Phaiax/eggbot/Einkaufsliste_Backup1.ods

Einkaufsliste
arduino nano |  | 11 | bestellt |  | übersicht | https://www.arduino.cc/en/Main/ArduinoBoardNano
 |  |  |  |  | schaltplan | http://download.arduino.org/products/NANO/Arduino%20Nano-Rev3.2-SCH.pdf
 |  |  |  |  | atmega summary | http://www.atmel.com/Images/Atmel-42735-8-bit-AVR-Microcontroller-ATmega328-328P_Summary.pdf
Raspberry |  | 39 | bestellt | da | pinout | http://www.panu.it/raspberry/
 |  |  |  |  | goio benchmark | http://codeandlife.com/2012/07/03/benchmarking-raspberry-pi-gpio-speed/
 |  |  |  |  | features | http://elinux.org/RPi_Hardware
Wlan stick |  | 5 | bestellt | da
micro sd karte |  | 8 | bestellt | da
netzteil |  | 17.63 | bestellt | da da
2 stepper | 1.8 grad | 17.1 | bestellt | da |  | http://www.ebay.de/itm/262038536473
2 stepper driver |  | 11.55 | bestellt | da |  | http://www.ebay.de/itm/221727610250
baumarkt schrauben |  | 15
stifte |  | 15
holzverkleidung |  | 15
level shufter |  | 4.29 | bestellt |  |  | http://www.ebay.de/itm/222080420936
servo 10 stk |  | 18 | bestellt | da |  | http://www.ebay.de/itm/331886379174
tastenfeld |  | 7.26 | bestellt |  |  | 12 pins + 1 Gnd
oled |  | 9 | bestellt | da |  | http://www.ebay.de/itm/222193031364
 |  | 181.82999999999996
 |  | 200
