Phaiax/eggbot/stls/arm1.stl

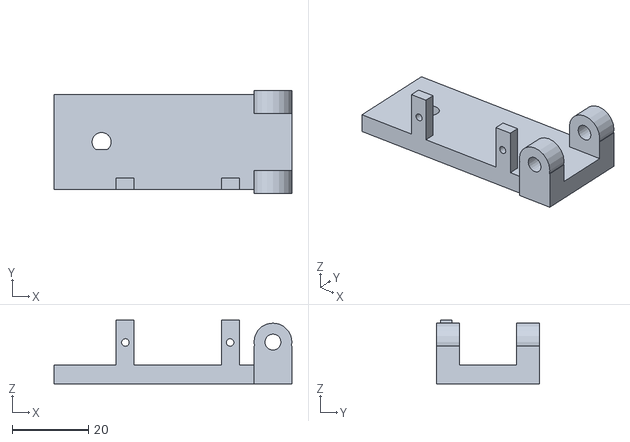
[picture p1: CAD file, 2016-12-21]
stls/arm1.stl
62.5 x 27.0 x 16.8
