Phaiax/eggbot/vertical_ARM_v2.stl

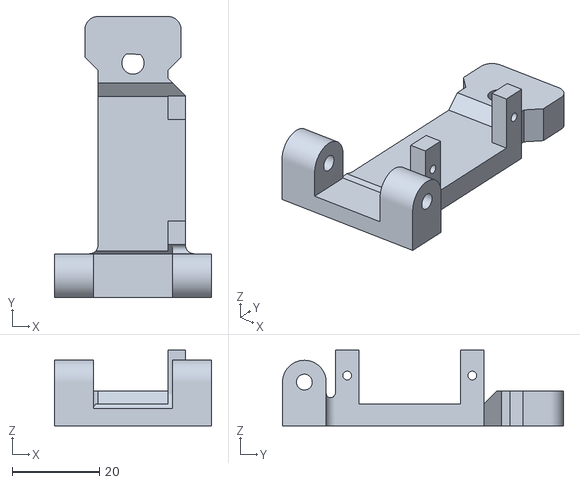
[picture p2: CAD file, 2016-12-21]
vertical_ARM_v2.stl
36.0 x 64.3 x 17.3
