Phaiax/eggbot/pen_holder_v3.stl

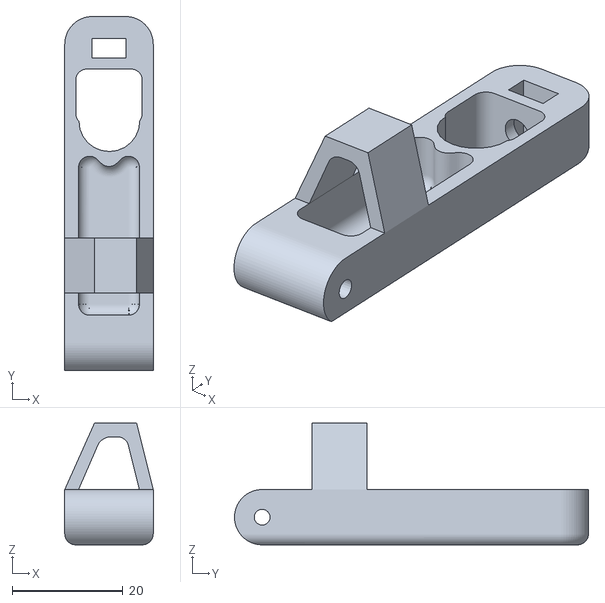
[picture p3: CAD file, 2016-12-21]
pen_holder_v3.stl
16.0 x 64.0 x 22.0
