Phaiax/eggbot/stls/elevator.stl

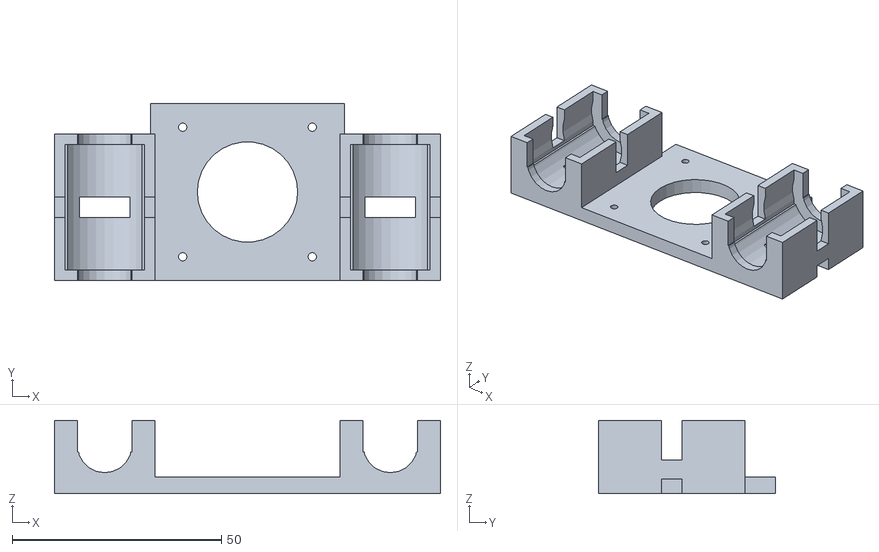
[picture p4: CAD file, 2016-12-21]
stls/elevator.stl
92.3 x 42.3 x 17.5
