Phaiax/eggbot/pi_bottom.stl

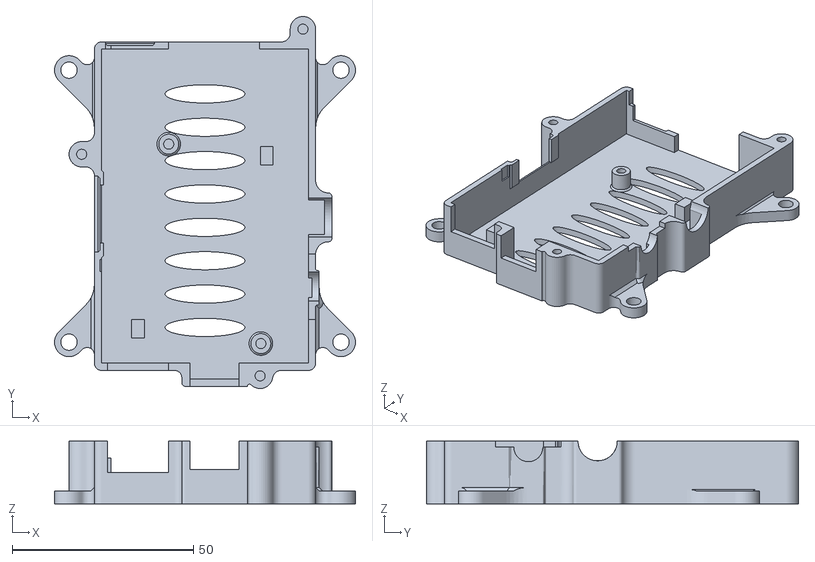
[picture p5: CAD file, 2016-12-04]
pi_bottom.stl
83.0 x 102.6 x 17.3
