Phaiax/eggbot/stls/eggholder_top.stl

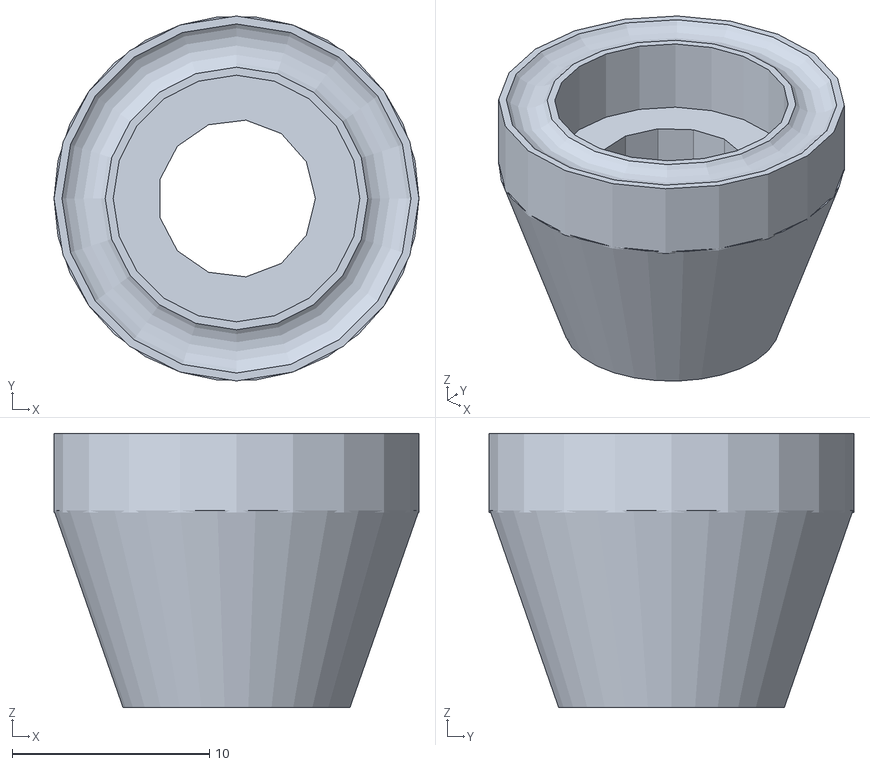
[picture p6: CAD file, 2016-12-21]
stls/eggholder_top.stl
18.5 x 18.5 x 13.9
