Phaiax/eggbot/pi_top.stl

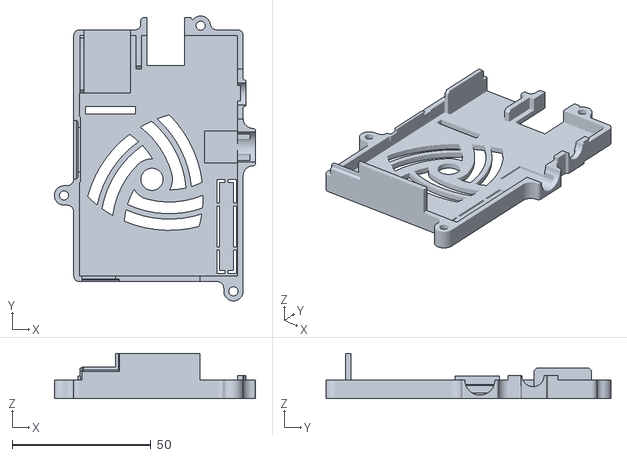
[picture p7: CAD file, 2016-12-04]
pi_top.stl
72.5 x 102.6 x 16.4
