Phaiax/eggbot/stls/arm2.stl

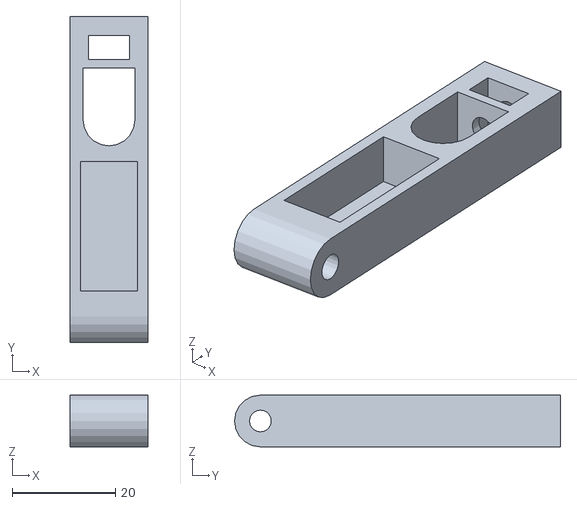
[picture p8: CAD file, 2016-12-21]
stls/arm2.stl
15.0 x 63.0 x 10.0
