Phaiax/eggbot/stls/arm1_extra.stl

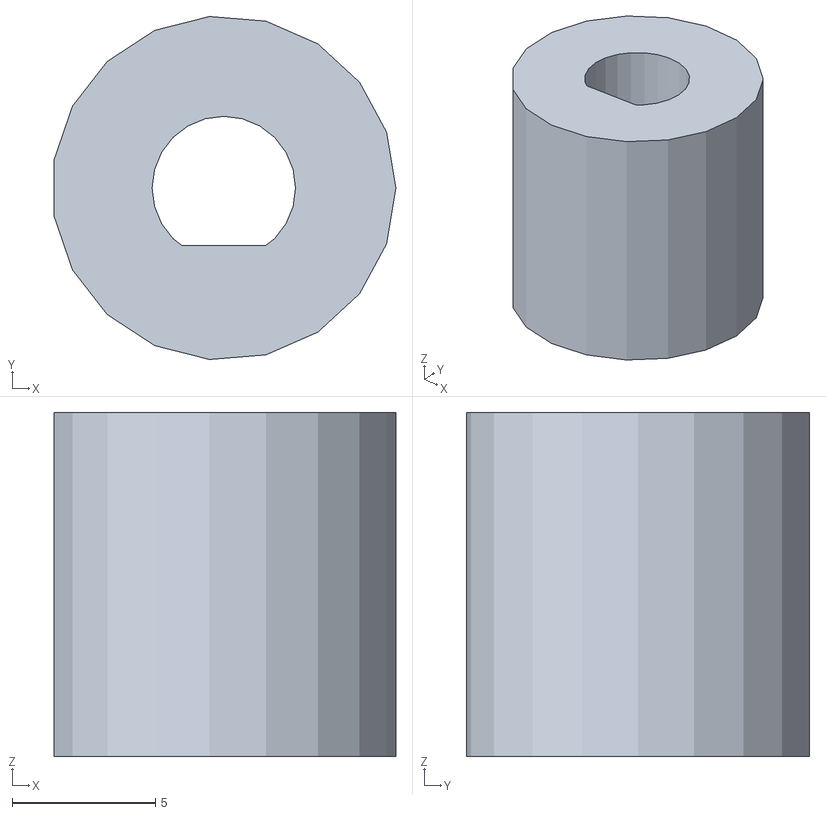
[picture p9: CAD file, 2016-12-21]
stls/arm1_extra.stl
11.9 x 12.0 x 12.0
