Phaiax/eggbot/stls/clamp.stl

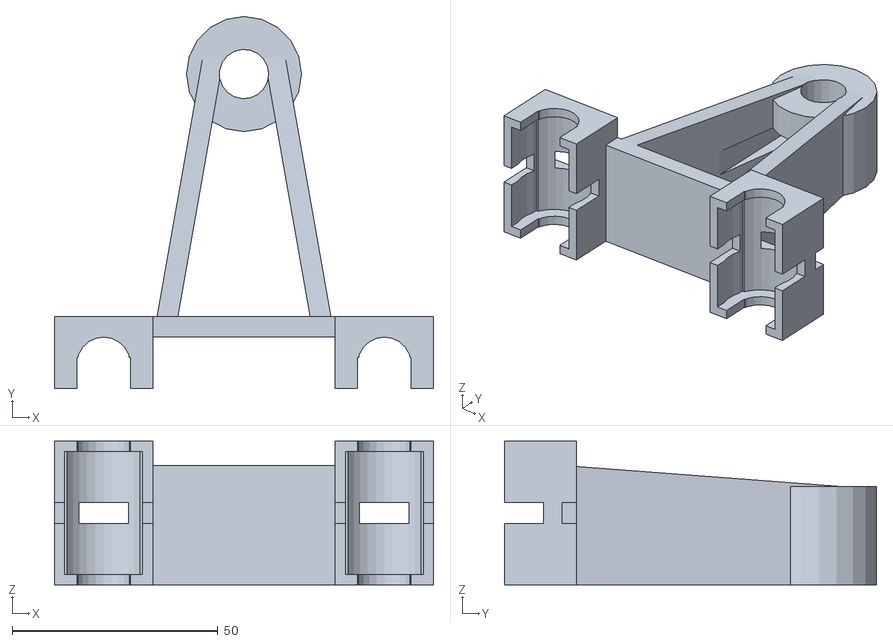
[picture p10: CAD file, 2016-12-21]
stls/clamp.stl
92.3 x 90.5 x 35.0
