Phaiax/eggbot/stls/eggholder_bot.stl

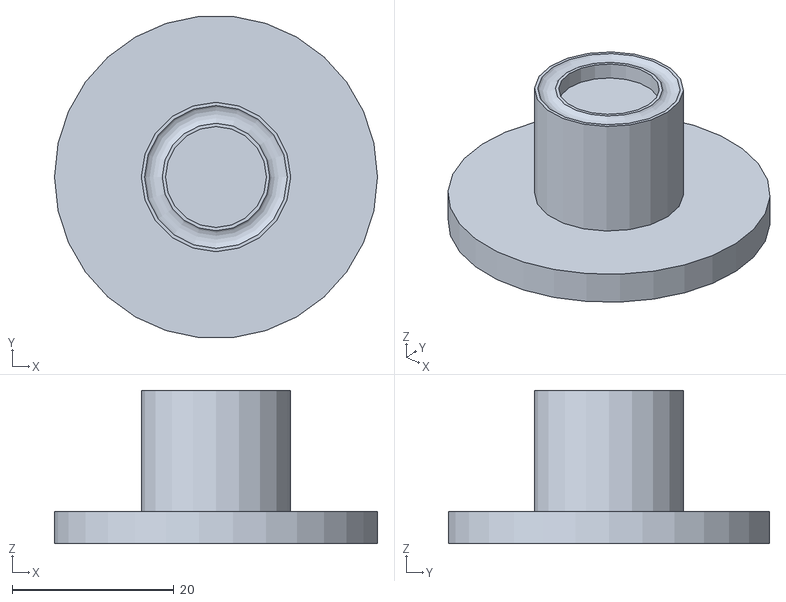
[picture p11: CAD file, 2016-12-21]
stls/eggholder_bot.stl
40.0 x 39.8 x 19.0
