Phaiax/eggbot/(list of files, cad)

Other CAD files:
unused.scad
