Phaiax/eggbot/schematics/eggbothat3.brd

## EAGLE design schematics/eggbothat3.brd (2016-12-13)

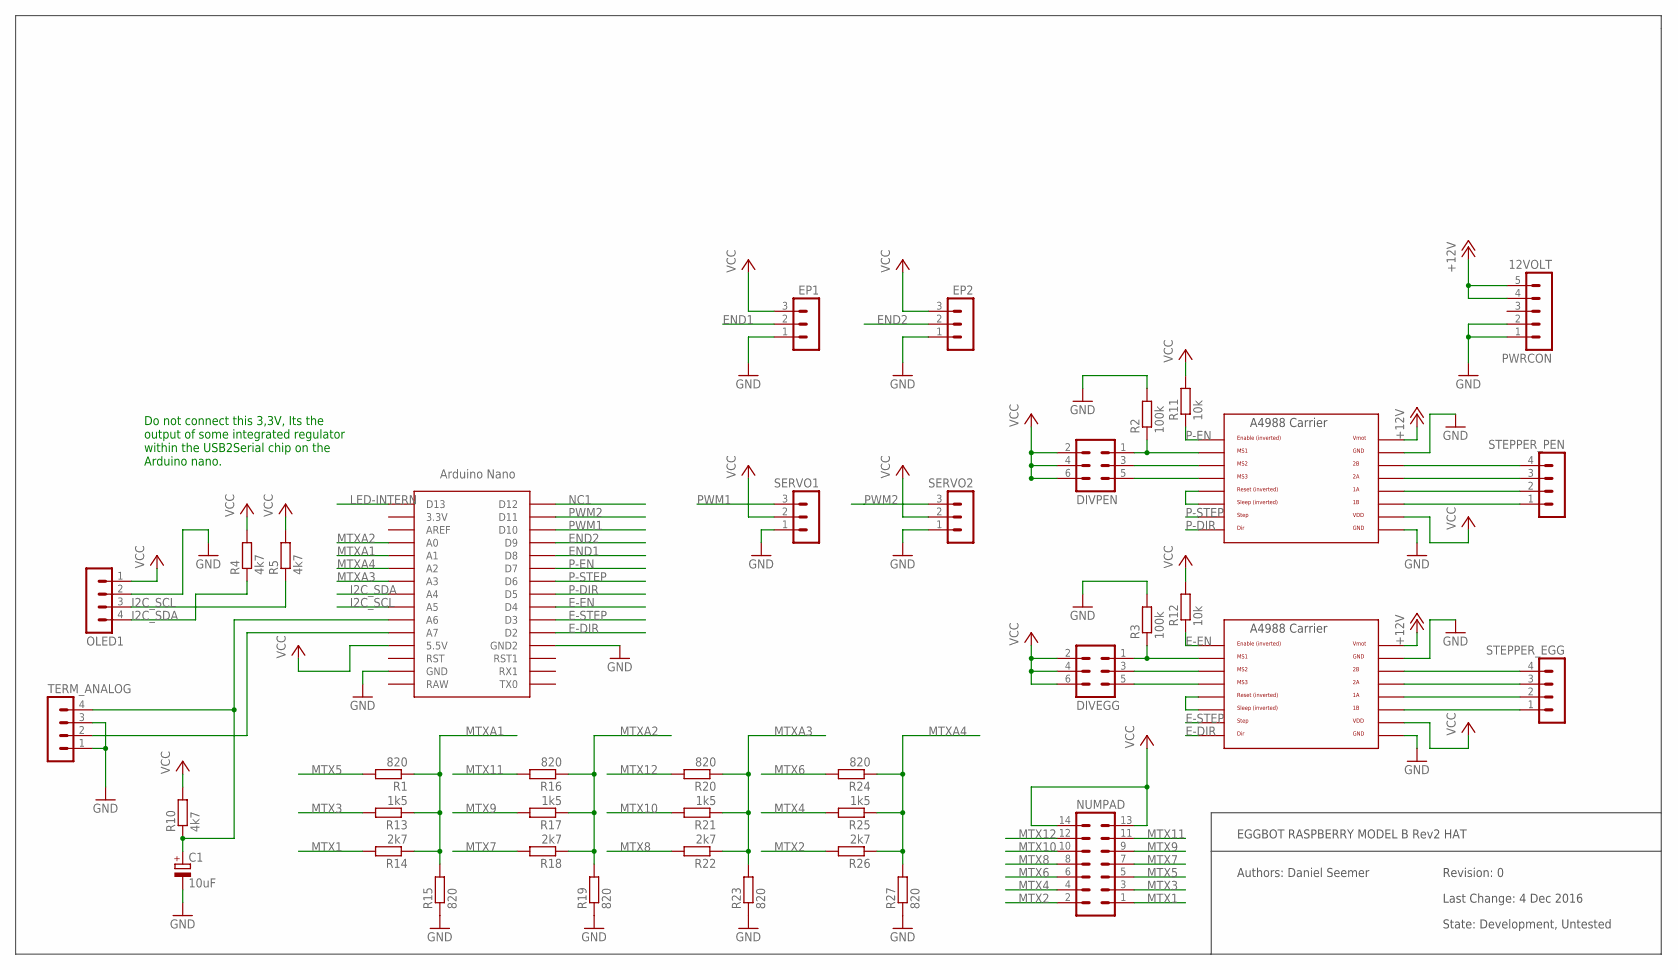
[picture p12: schematic eggbothat3.sch, sheet 1]

Parts:
12VOLT: PWRCON; MA05-1
C1: 10uF; E2,5-5
DIVEGG: MA03-2
DIVPEN: MA03-2
EP1, EP2: MA03-1
NUMPAD: MA07-2
OLED1: MA04-1
R1, R15, R16, R19, R20, R23, R24, R27: 820; R1206
R2, R3: 100k; R1206
R4, R5, R10: 4k7; R1206
R11, R12: 10k; R1206
R13, R17, R21, R25: 1k5; R1206
R14, R18, R22, R26: 2k7; R1206
SERVO1, SERVO2: MA03-1
STEPPER_EGG: MA04-1
STEPPER_PEN: MA04-1
TERM_ANALOG: MA04-1
U$1, U$2: A4988BREAKOUT
U$4: NANO

Connections:
+12V: 12VOLT.4, 12VOLT.5, U$1.VMOT, U$2.VMOT
E-DIR: U$2.DIR, U$4.D2
E-EN: R12.1, U$2.EN, U$4.D4
E-STEP: U$2.STEP, U$4.D3
END1: EP1.2, U$4.D8
END2: EP2.2, U$4.D9
GND: 12VOLT.1, 12VOLT.2, C1.-, EP1.1, EP2.1, OLED1.2, R2.2, R3.2, R15.1, R19.1, R23.1, R27.1, SERVO1.1, SERVO2.1, TERM_ANALOG.1, TERM_ANALOG.3, U$1.GND, U$1.GND@0 (GND), U$2.GND, U$2.GND@0 (GND), U$4.GND, U$4.GND1 (GND2)
I2C_SCL: OLED1.3, R5.1, U$4.A5
I2C_SDA: OLED1.4, R4.1, U$4.A4
LED-INTERN: U$4.D13
MTX1: NUMPAD.1, R14.2
MTX2: NUMPAD.2, R26.2
MTX3: NUMPAD.3, R13.2
MTX4: NUMPAD.4, R25.2
MTX5: NUMPAD.5, R1.2
MTX6: NUMPAD.6, R24.2
MTX7: NUMPAD.7, R18.2
MTX8: NUMPAD.8, R22.2
MTX9: NUMPAD.9, R17.2
MTX10: NUMPAD.10, R21.2
MTX11: NUMPAD.11, R16.2
MTX12: NUMPAD.12, R20.2
MTXA1: R1.1, R13.1, R14.1, R15.2, U$4.A1
MTXA2: R16.1, R17.1, R18.1, R19.2, U$4.A0
MTXA3: R20.1, R21.1, R22.1, R23.2, U$4.A3
MTXA4: R24.1, R25.1, R26.1, R27.2, U$4.A2
unnamed: STEPPER_PEN.4, U$1.2B
unnamed: STEPPER_PEN.3, U$1.2A
unnamed: STEPPER_PEN.2, U$1.1A
unnamed: STEPPER_PEN.1, U$1.1B
unnamed: STEPPER_EGG.4, U$2.2B
unnamed: STEPPER_EGG.3, U$2.2A
unnamed: STEPPER_EGG.2, U$2.1A
unnamed: STEPPER_EGG.1, U$2.1B
unnamed: DIVPEN.3, U$1.MS2
unnamed: DIVPEN.1, R2.1, U$1.MS1
unnamed: DIVPEN.5, U$1.MS3
unnamed: DIVEGG.3, U$2.MS2
unnamed: DIVEGG.1, R3.1, U$2.MS1
unnamed: DIVEGG.5, U$2.MS3
unnamed: U$1.RST, U$1.SLP (SLEEP)
unnamed: U$2.RST, U$2.SLP (SLEEP)
unnamed: C1.+, R10.1, TERM_ANALOG.4, U$4.A6
unnamed: TERM_ANALOG.2, U$4.A7
NC1: U$4.D12
P-DIR: U$1.DIR, U$4.D5
P-EN: R11.1, U$1.EN, U$4.D7
P-STEP: U$1.STEP, U$4.D6
PWM1: SERVO1.3, U$4.D10
PWM2: SERVO2.3, U$4.D11
VCC: DIVEGG.2, DIVEGG.4, DIVEGG.6, DIVPEN.2, DIVPEN.4, DIVPEN.6, EP1.3, EP2.3, NUMPAD.13, NUMPAD.14, OLED1.1, R4.2, R5.2, R10.2, R11.2, R12.2, SERVO1.2, SERVO2.2, U$1.VDD, U$2.VDD, U$4.5V (5.5V)

Notes on the sheet:
Do not connect this 3,3V, Its the output of some integrated regulator within the USB2Serial chip on the Arduino nano.
EGGBOT RASPBERRY MODEL B Rev2 HAT
Authors: Daniel Seemer
Last Change: 4 Dec 2016
State: Development, Untested
Revision: 0

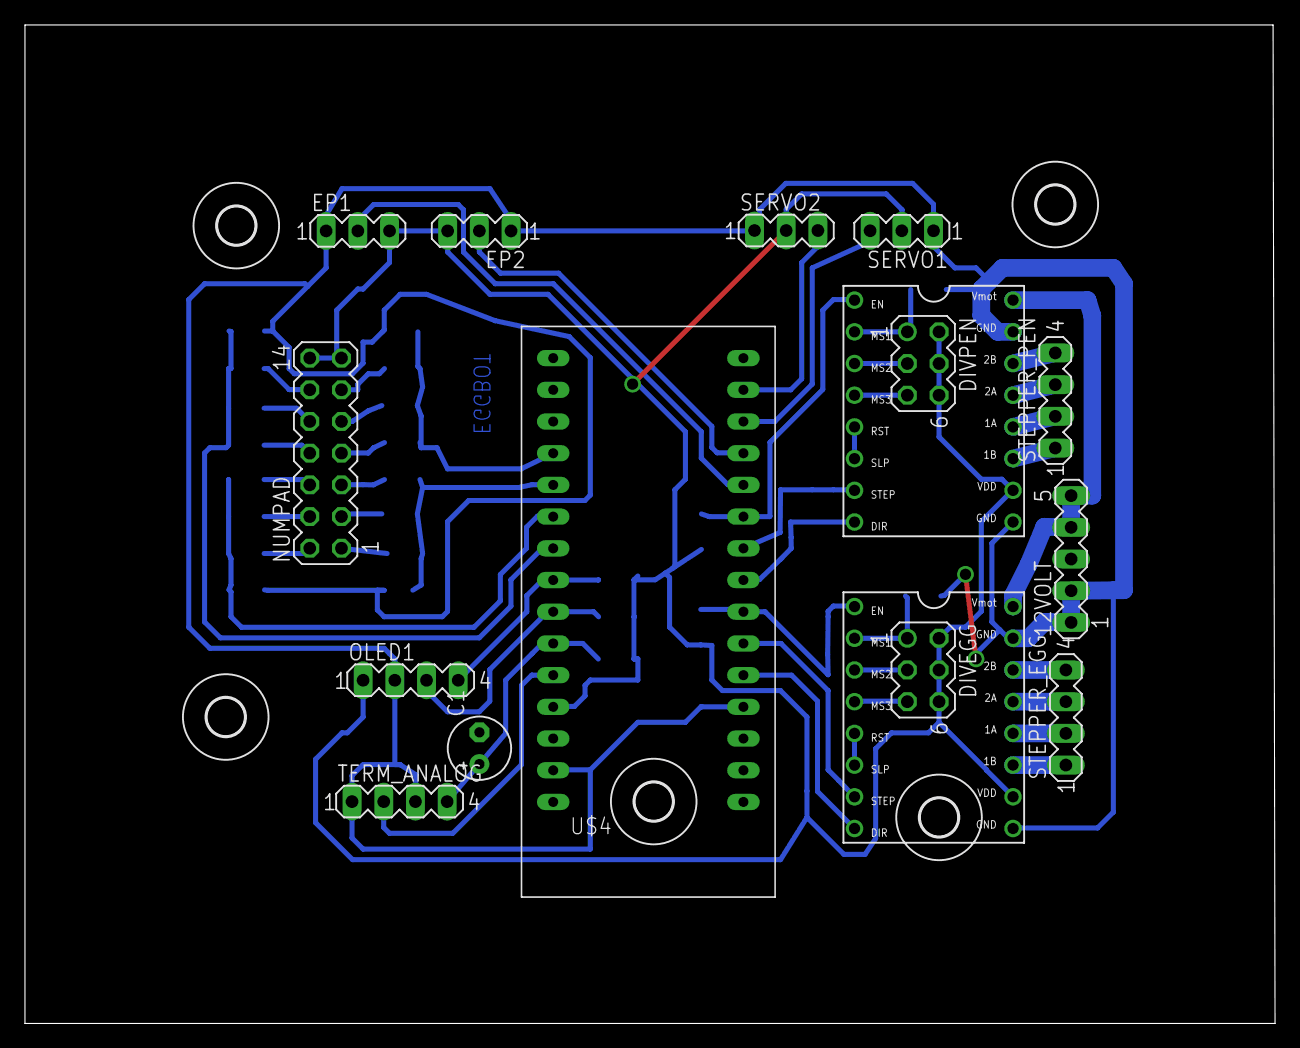
[picture p13: board eggbothat3.brd from above]

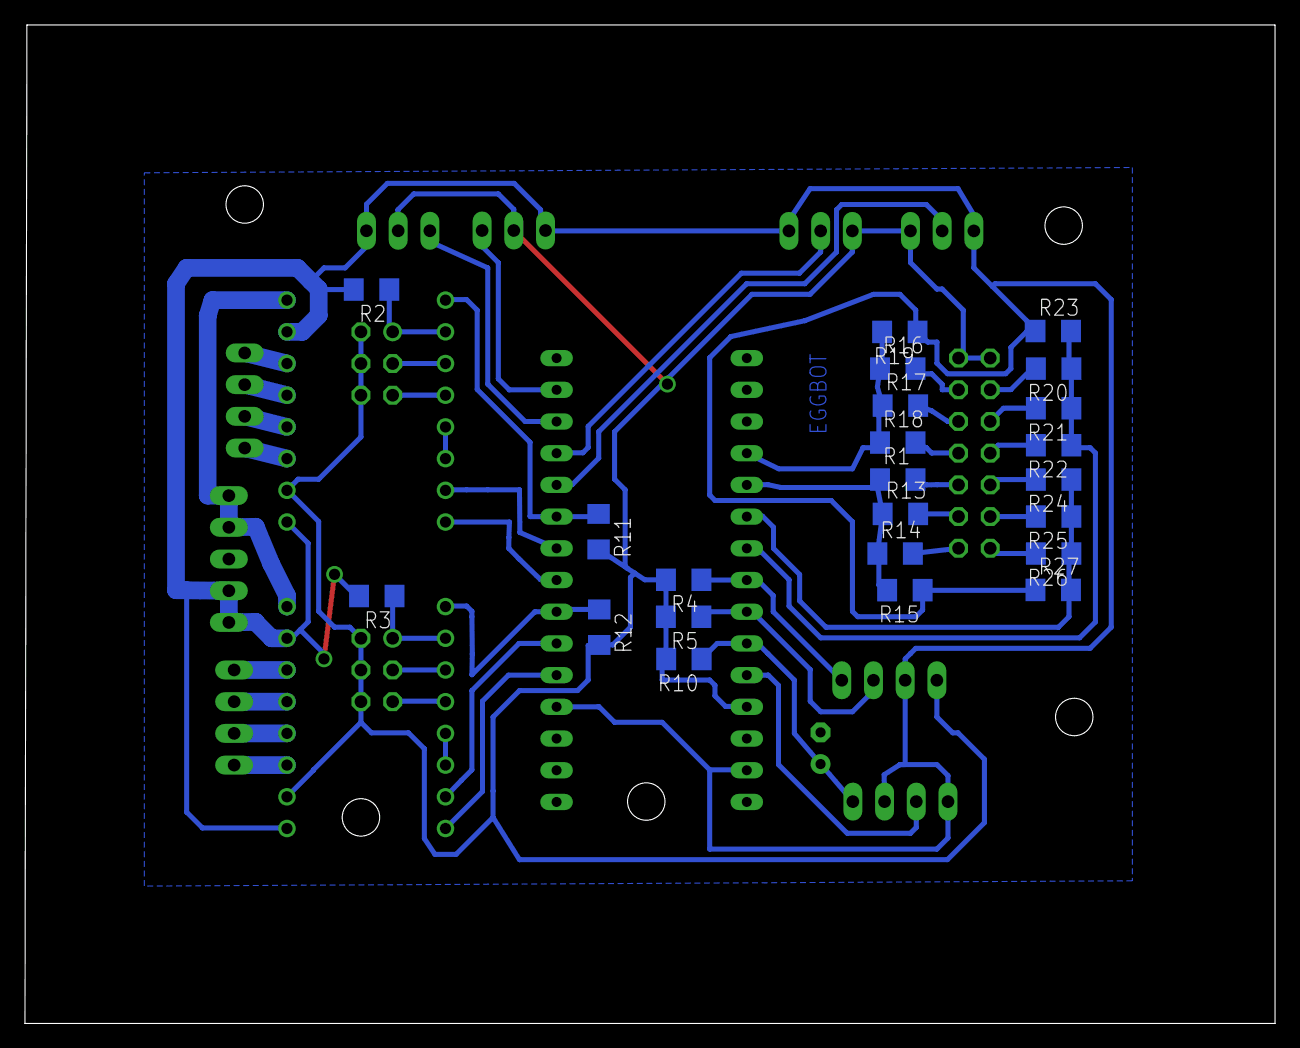
[picture p14: board eggbothat3.brd from below]

Board: 2 copper layers, 100.2 x 80.0 mm, 44 parts (23 on the bottom side), 49 nets.

Other parts of the board:
U$3, U$5, U$6, U$7, U$8: 3,0
