Phaiax/eggbot/arduinonanotest/src/Configuration.h

#define CONFIGURATION_H
#include "pins.h"
#define DRIVE_SYSTEM 0
#define XAXIS_STEPS_PER_MM 98.425196
#define YAXIS_STEPS_PER_MM 98.425196
#define ZAXIS_STEPS_PER_MM 2560
#define SUPPORT_LASER 0 // set 1 to enable laser support
#define LASER_PIN -1    // set to pin enabling laser
#define LASER_ON_HIGH 1 // Set 0 if low signal enables laser
#define SUPPORT_CNC 0 // Set 1 for CNC support
#define CNC_WAIT_ON_ENABLE 300 // wait x milliseconds after enabling
#define CNC_WAIT_ON_DISABLE 0 // delay in milliseconds after disabling spindle. May be required for direction changes.
#define CNC_ENABLE_PIN -1 // Pin to enable mill
#define CNC_ENABLE_WITH 1 // Set 0 if low enables spindle
#define CNC_DIRECTION_PIN -1 // Set to pin if direction control is possible
#define CNC_DIRECTION_CW 1 // Set signal required for clockwise rotation
#define DEFAULT_PRINTER_MODE PRINTER_MODE_FFF
#define ENDSTOP_PULLUP_X_MIN false
#define ENDSTOP_PULLUP_Y_MIN false
#define ENDSTOP_PULLUP_Z_MIN false
#define ENDSTOP_PULLUP_X_MAX true
#define ENDSTOP_PULLUP_Y_MAX true
#define ENDSTOP_PULLUP_Z_MAX false
#define ENDSTOP_X_MIN_INVERTING true
#define ENDSTOP_Y_MIN_INVERTING true
#define ENDSTOP_Z_MIN_INVERTING true
#define ENDSTOP_X_MAX_INVERTING false
#define ENDSTOP_Y_MAX_INVERTING false
#define ENDSTOP_Z_MAX_INVERTING true
#define MIN_HARDWARE_ENDSTOP_X true
#define MIN_HARDWARE_ENDSTOP_Y true
#define MIN_HARDWARE_ENDSTOP_Z false
#define MAX_HARDWARE_ENDSTOP_X false
#define MAX_HARDWARE_ENDSTOP_Y false
#define MAX_HARDWARE_ENDSTOP_Z true
#define X_ENABLE_ON 0
#define Y_ENABLE_ON 0
#define Z_ENABLE_ON 0
#define DISABLE_X false
#define DISABLE_Y false
#define DISABLE_Z false
#define DISABLE_E false
#define INVERT_X_DIR true
#define INVERT_Y_DIR true
#define INVERT_Z_DIR true
#define X_HOME_DIR -1
#define Y_HOME_DIR -1
#define Z_HOME_DIR 1
#define max_software_endstop_r true
#define min_software_endstop_x false
#define min_software_endstop_y false
#define min_software_endstop_z false
#define max_software_endstop_x true
#define max_software_endstop_y true
#define max_software_endstop_z false
#define ENDSTOP_X_BACK_MOVE 5
#define ENDSTOP_Y_BACK_MOVE 5
#define ENDSTOP_Z_BACK_MOVE 2
#define ENDSTOP_X_RETEST_REDUCTION_FACTOR 2
#define ENDSTOP_Y_RETEST_REDUCTION_FACTOR 2
#define ENDSTOP_Z_RETEST_REDUCTION_FACTOR 2
#define ENDSTOP_X_BACK_ON_HOME 1
#define ENDSTOP_Y_BACK_ON_HOME 1
#define ENDSTOP_Z_BACK_ON_HOME 0
#define ALWAYS_CHECK_ENDSTOPS 1
#define X_MAX_LENGTH 165
#define Y_MAX_LENGTH 175
#define Z_MAX_LENGTH 116.820
#define X_MIN_POS 0
#define Y_MIN_POS 0
#define Z_MIN_POS 0
#define MICROSTEP_MODES {8,8,8,8,8} // [1,2,4,8,16]
#if MOTHERBOARD==301
#define MOTOR_CURRENT_PERCENT {53,53,53,53,53}
#elif MOTHERBOARD==12
#define MOTOR_CURRENT_PERCENT {55,55,55,55,55}
#endif
#define STEPPER_INACTIVE_TIME 360
#define MAX_INACTIVE_TIME 0L
#define MAX_FEEDRATE_X 200
#define MAX_FEEDRATE_Y 200
#define MAX_FEEDRATE_Z 5
#define HOMING_FEEDRATE_X 80
#define HOMING_FEEDRATE_Y 80
#define HOMING_FEEDRATE_Z 3
#define HOMING_ORDER HOME_ORDER_ZXY
#define ZHOME_MIN_TEMPERATURE 0
#define ZHOME_HEAT_ALL 1
#define ZHOME_HEAT_HEIGHT 20
#define ZHOME_X_POS IGNORE_COORDINATE
#define ZHOME_Y_POS IGNORE_COORDINATE
#define ENABLE_BACKLASH_COMPENSATION 0
#define Z_BACKLASH 0
#define X_BACKLASH 0
#define Y_BACKLASH 0
#define RAMP_ACCELERATION 1
#define STEPPER_HIGH_DELAY 0
#define DIRECTION_DELAY 0
#define STEP_DOUBLER_FREQUENCY 12000
#define ALLOW_QUADSTEPPING 1
#define DOUBLE_STEP_DELAY 0 // time in microseconds
#define KEEP_ALIVE_INTERVAL 2000
#define MAX_ACCELERATION_UNITS_PER_SQ_SECOND_X 1000
#define MAX_ACCELERATION_UNITS_PER_SQ_SECOND_Y 1000
#define MAX_ACCELERATION_UNITS_PER_SQ_SECOND_Z 100
#define MAX_TRAVEL_ACCELERATION_UNITS_PER_SQ_SECOND_X 2000
#define MAX_TRAVEL_ACCELERATION_UNITS_PER_SQ_SECOND_Y 2000
#define MAX_TRAVEL_ACCELERATION_UNITS_PER_SQ_SECOND_Z 100
#define INTERPOLATE_ACCELERATION_WITH_Z 0
#define ACCELERATION_FACTOR_TOP 100
#define MAX_JERK 20.0
#define MAX_ZJERK 0.3
#define PRINTLINE_CACHE_SIZE 16
#define MOVE_CACHE_LOW 10
#define LOW_TICKS_PER_MOVE 250000
#define BAUDRATE 115200
#define ENABLE_POWER_ON_STARTUP 1
#define POWER_INVERTING 0
#define KILL_METHOD 1
#define ACK_WITH_LINENUMBER 1
#define WAITING_IDENTIFIER "wait"
#define ECHO_ON_EXECUTE 1
#define EEPROM_MODE 0
#define FEATURE_SERVO 2
#define SERVO0_PIN 10
#define SERVO1_PIN 11
#define SERVO2_PIN 5
#define SERVO3_PIN 4
#define SERVO0_NEUTRAL_POS  -1
#define SERVO1_NEUTRAL_POS  -1
#define SERVO2_NEUTRAL_POS  -1
#define SERVO3_NEUTRAL_POS  -1
#define UI_SERVO_CONTROL 0
#define FAN_KICKSTART_TIME  200
#define FEATURE_WATCHDOG 1
#define FEATURE_BABYSTEPPING 0
#define BABYSTEP_MULTIPLICATOR 1
#define CASE_LIGHTS_PIN -1
#define CASE_LIGHT_DEFAULT_ON 1
#define ARC_SUPPORT 1
#define FEATURE_MEMORY_POSITION 1
#define FEATURE_CHECKSUM_FORCED 0
#define NUM_MOTOR_DRIVERS 0
#define MOTOR_DRIVER_1(var) StepperDriver<E1_STEP_PIN, E1_DIR_PIN, E1_ENABLE_PIN, false, false> var(100.0f,5.0f)
