Phaiax/eggbot/(commit log)

2016-12-03 Eggbot openscad sketch
    [Nema17.scad, eggbot.scad, servosg90.scad]
2016-12-04 schematics and board
    [eggbothat.brd, eggbothat.sch]
2016-12-04 PI stl
    [pi_bottom.stl, pi_top.stl]
2016-12-04 BOM backup
    [Einkaufsliste_Backup1.ods]
2016-12-04 continue scratching: PI
    [eggbot.scad]
2016-12-04 schematic fixes
    [eggbothat.brd, eggbothat.sch]
2016-12-04 try pen motor elevator
    [eggbot.scad, eggbothat.brd, gears_spur.scad]
2016-12-08 Add ring holders, refactor
    [Nema17.scad, arm.scad, clamp.scad, eggbot.scad, eggholder.scad, lm8uumount.scad, small_stuff.scad, unused.scad]
2016-12-09 Second version of schematics
    [eggbothat2.brd, eggbothat2.sch]
2016-12-11 versions 2,3 of electronics
    [eggbothat3.brd, eggbothat3.sch]
2016-12-13 Board update (don't know exactly what)
    [eggbothat3.brd]
2016-12-13 3D model update
    [clamp.scad, eggbot.scad, eggholder.scad, lm8uumount.scad, servosg90.scad]
2016-12-13 Arduino and host test code
2016-12-17 Communication between Arduino and host
    [Configuration.h]
2016-12-21 gears and eggbot stls from thingiverse as comparision
    [pen_holder_v3.stl, vertical_ARM_v2.stl]
2016-12-21 model update
    [arm.scad, eggbot.scad, small_stuff.scad]
2016-12-21 communication and servo tests
2016-12-21 schematic change?
2016-12-21 ready for printing
    [arm.scad, clamp.scad, eggbot.scad, eggholder.scad, small_stuff.scad]
2016-12-21 Nema screws
    [arm.scad]
2016-12-21 switch to lm10uu, export as stl
    [arm1.stl, arm1_extra.stl, arm2.stl, clamp.stl, eggbot.scad, eggholder.scad, eggholder_bot.stl, eggholder_top.stl]
